SphericalCowww/CubicDoggo_14A/README.md

# CubicDoggo 14A: Homemade 12-DOF 4-Legged Robot Recipe with 6-DOF Arm
Cubic Doggo 14A Googboi is developed from [Cubic Doggo 07B Wouf](https://github.com/SphericalCowww/CubicDoggo_07B), incorporating an [SO-101 arm](https://huggingface.co/docs/lerobot/en/so101). The robot is the simplest Cubic Doggo built for the [Tag of Flag](https://github.com/SphericalCowww/tag_of_flag) game.

## Running SO-101 arms

### Initializing SO-101 with LeRobot services

Note that for this setup, the leader arms are assumed to use virtual servos, such as STS3215-C066 (or WaveShare ST3215 (SE)) that have 7.2 V grading (powered by 5 V supply). 

The servo IDs are 6-1 from top to bottom. Remember to always put on the PLA holder for servo 5 and connect both wires before any other part, as the wires will otherwise be extremely difficult to access afterwards. Then install the arms following [HuggingFace](https://huggingface.co/docs/lerobot/en/so101).

Plug the driver board into the Raspberry Pi:

    dmesg | tail -30
    ls -l /dev/ttyACM*                      # or whatever connection is found
    sudo usermod -aG dialout $USER
    sudo reboot

Install,

    sudo apt install python3.12-venv libevdev-dev ffmpeg

Set up the Python environment to install [LeRobot](https://github.com/huggingface/lerobot),

    cd CubicDoggo_14A/
    cd ..
    python3 -m venv CubicDoggo_14A_env
    source CubicDoggo_14A_env/bin/activate
    pip install --upgrade pip jinja2 pyyaml typeguard setuptools wheel
    git clone https://github.com/huggingface/lerobot.git
    cd lerobot
    pip install -e .
    pip install -e ".[feetech]"

Follow the calibration steps for the follower (see also [YouTube](https://www.youtube.com/watch?v=Nhfda8h7e2I)),

    # plug in the driver board
    lerobot-find-port
    # unplug the driver board
    ## The port of this MotorsBus is '/dev/ttyACM0'
    # plug in the driver board
    ls -l /dev/serial/by-id/
    ## ... usb-1a86_USB_Single_Serial_5C93149822-if00 -> ../../ttyACM0
    lerobot-setup-motors --robot.type=so101_follower --robot.port=/dev/serial/by-id/usb-1a86_USB_Single_Serial_5C93149822-if00
    # Connecting the servos from top to bottom independently to the driver board one-by-one, following the instructions
    ## ... 'shoulder_pan' motor id set to 1
    # After completion, connect all servos in a daisy chain 
    lerobot-calibrate --robot.type=so101_follower --robot.port=/dev/serial/by-id/usb-1a86_USB_Single_Serial_5C93149822-if00 --robot.id=my_follower
    # Follow the instructions

For the leader:

    ls -l /dev/serial/by-id/
    ## ... usb-1a86_USB_Single_Serial_5C93152513-if00 -> ../../ttyACM0
    lerobot-setup-motors --teleop.type=so101_leader --teleop.port=/dev/serial/by-id/usb-1a86_USB_Single_Serial_5C93152513-if00
    # ...
    lerobot-calibrate --teleop.type=so101_leader --teleop.port=/dev/serial/by-id/usb-1a86_USB_Single_Serial_5C93152513-if00 --teleop.id=my_leader

Once everything is done,

    deactivate

### Running SO-101 on ROS

    cd CubicDoggo_14A/
    cd ..
    mkdir so101_ros2
    cd so101_ros2
    git clone https://github.com/adoodevv/so101_ros2.git
    mv so101_ros2 src
    sudo rosdep init
    rosdep update
    rosdep install --from-paths src --ignore-src -r -y
    colcon build --symlink-install
    source install/setup.bash

Connect both driver boards and test out the calibration files, 

    ros2 run so101_hardware so101_hardware_check --port /dev/serial/by-id/usb-1a86_USB_Single_Serial_5C93149822-if00 --calibration ~/.cache/huggingface/lerobot/calibration/robots/so_follower/my_follower.json
    ros2 run so101_hardware so101_hardware_check --port /dev/serial/by-id/usb-1a86_USB_Single_Serial_5C93152513-if00 --calibration ~/.cache/huggingface/lerobot/calibration/teleoperators/so_leader/my_leader.json

Then launch the arms,

    # For no torque with rViz
    ros2 launch so101_bringup so101_real_moveit.launch.py port:=/dev/serial/by-id/usb-1a86_USB_Single_Serial_5C93149822-if00 read_only:=true
    # For powered without rViz
    ros2 launch so101_bringup so101_real_moveit.launch.py port:=/dev/serial/by-id/usb-1a86_USB_Single_Serial_5C93149822-if00 use_rviz:=false 
    # For teleop
    ros2 launch so101_bringup so101_teleop.launch.py port:=/dev/serial/by-id/usb-1a86_USB_Single_Serial_5C93149822-if00 leader_port:=/dev/serial/by-id/usb-1a86_USB_Single_Serial_5C93152513-if00 use_rviz:=false 

## Running servos for the legs

### Initializing servos in ROS with STServo library

Requirement: install ROS2 Jazzy on a Raspberry Pi according to [GitHub](https://github.com/SphericalCowww/ROS_init_practice).

Download ``ST/SC serial bus servo control library (Linux)`` from <a href="https://www.waveshare.com/wiki/Bus_Servo_Adapter_(A)">link</a>, expand it under ``CubicDoggo_14A/src/my_toolbox_scs_workbench/`` and replace ``src/my_toolbox_scs_workbench/SCServo_Linux/SCServo_Linux_220329/SCServo_Linux/CMakeLists.txt``.

    cd CubicDoggo_14A/
    colcon build --packages-select my_toolbox_scs_workbench --cmake-clean-first
    source install/setup.bash

To change the servo ID and initialize the servo, connect only 1 controller and 1 servo,

    vim CubicDoggo_14A/src/my_toolbox_scs_workbench/src/scanUpdateID_zeroing.cpp
    # Modify targetID, EEPROM change is only enabled when ID changes 
    # Modify pos_offset_quick, when settled, set pos_offset_quick=0 and set pos_offset accordingly into the EEPROM
    ros2 run my_toolbox_scs_workbench scanUpdateID_zeroing

Or connect all the servos with IDs listed, update all their EEPROM at once with

    ros2 run my_toolbox_scs_workbench scanUpdateAll_zeroing

**WARNING: DO NOT CTRL-C FOR THESE EEPROM PROCESSES**

Remember to tune and record the pos_offset to set the servo at the correct default position (halfway between minimal and maximal ticks).

To test 1 servo again, do,

    ros2 run my_toolbox_scs_workbench testSpin_servo1

To test 2 servos with 2 controllers, or 3 servos daisy-chained, redo the connection accordingly and do,

    ros2 run my_toolbox_scs_workbench testSpin_servo2controller2
    ros2 run my_toolbox_scs_workbench testSpin_servo3

**NOTE:** Record the ``pos_offset`` for each servo independently such that each of their default position is finely aligned.

**NOTE:** ``sts_wb.writeByte``requires unlocking the EEPROM; do NOT do this firmware change too frequently, otherwise it can cause corruption.

## References:

- Trushant Adeshara, SO101 Arms: Calibration and Motor Configuration
 (<a href="https://www.youtube.com/watch?v=Nhfda8h7e2I">YouTube</a>)
- TheRobotStudio, SO-101 STL files, (<a href="https://github.com/TheRobotStudio/SO-ARM100/tree/main/STL/SO101/Individual">GitHub</a>)

## Acknowledgements

- SO-101 arm hardware kit purchased from [Waveshare](https://www.waveshare.com/wiki/SO-ARM100/101_Kit_Aassembly). Original hardware design by TheRobotStudio ([GitHub](https://github.com/TheRobotStudio/SO-ARM100)) under [Apache-2.0 license](https://github.com/TheRobotStudio/SO-ARM100/blob/main/LICENSE)
- SO-101 arm software package follows LeRobot [GitHub](https://github.com/huggingface/lerobot) under [Apache-2.0 license](https://github.com/huggingface/lerobot/blob/main/LICENSE)
- SO-101 ROS2 Jazzy control forked from adoodevv [GitHub](https://github.com/adoodevv/so101_ros2) under [BSD-3-Clause license](https://github.com/adoodevv/so101_ros2/blob/main/LICENSE)
- Libraries and some examples borrowed from Waveshare: https://www.waveshare.com/wiki/Bus_Servo_Adapter_(A). The license is not specified. For reference only
