SphericalCowww/CubicDoggo_14A/src/my_robot_description/mesh/CADv3_ST-3215-C018/mountArm-Body.stl

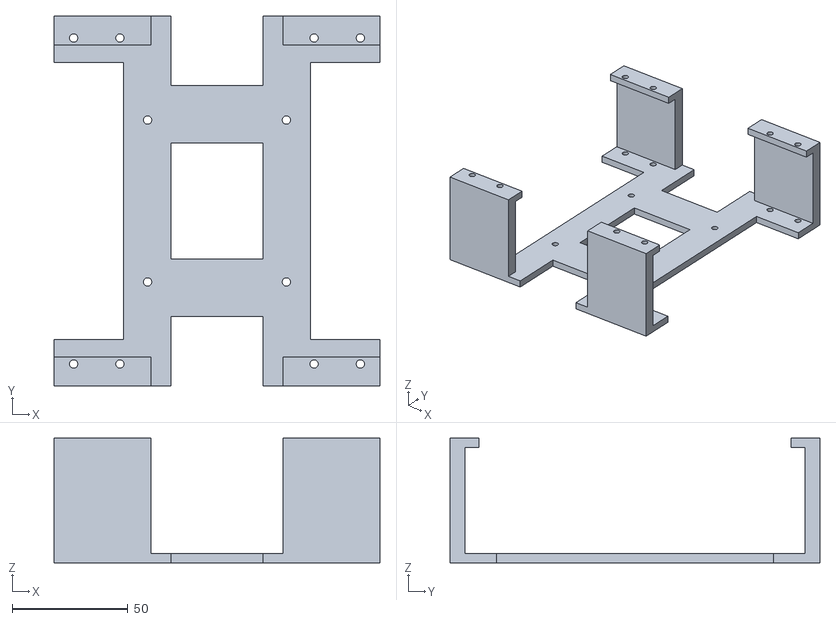
[picture p1: CAD file, 2026-11-07]
src/my_robot_description/mesh/CADv3_ST-3215-C018/mountArm-Body.stl
141.0 x 160.0 x 54.0
