SphericalCowww/CubicDoggo_14A/src/my_robot_description/mesh/CADv3_ST-3215-C018/mountFlag.FCStd

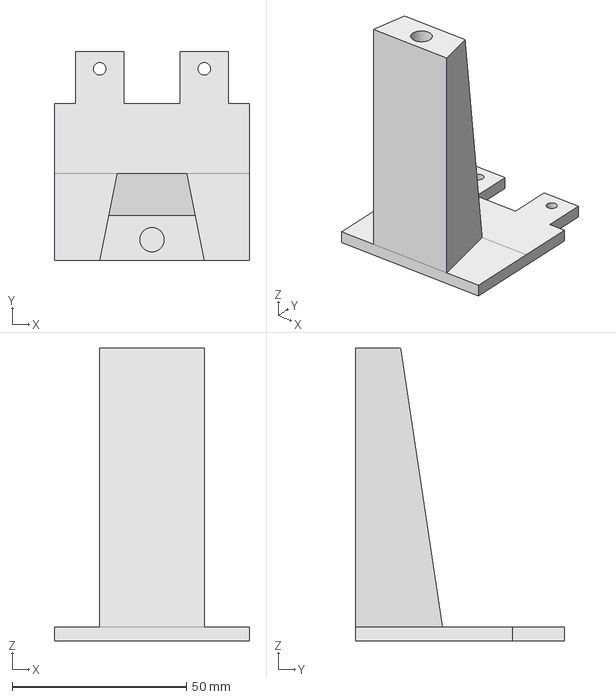
[picture p2: CAD file, 2026-11-07]
src/my_robot_description/mesh/CADv3_ST-3215-C018/mountFlag.FCStd
56.0 x 60.0 x 84.0 mm
