SphericalCowww/CubicDoggo_14A/src/my_robot_description/mesh/CADv3_ST-3215-C018/bodyHolderWide.FCStd

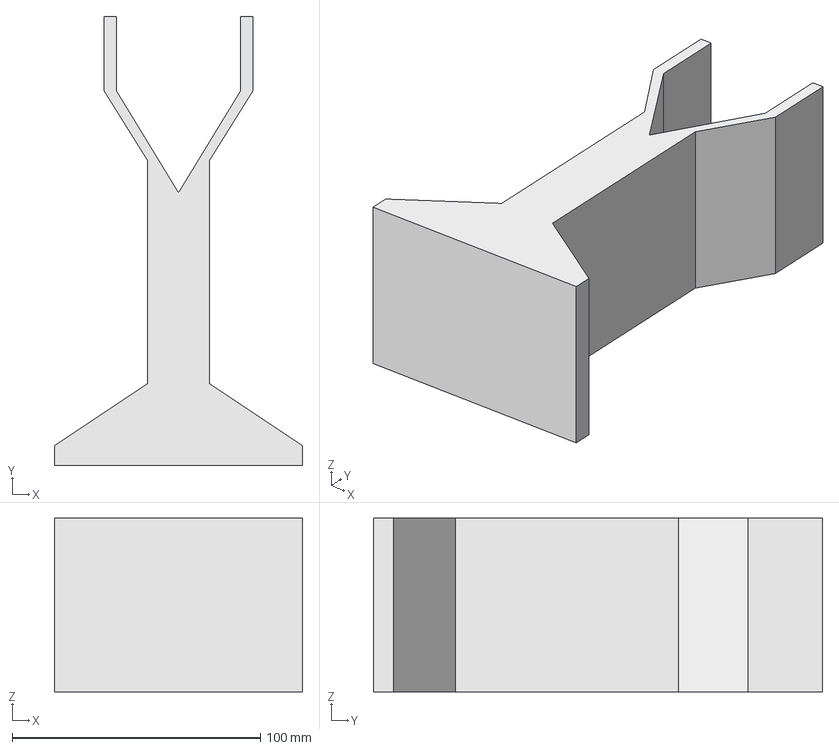
[picture p3: CAD file, 2026-11-06]
src/my_robot_description/mesh/CADv3_ST-3215-C018/bodyHolderWide.FCStd
100.0 x 181.0 x 70.0 mm
