SphericalCowww/CubicDoggo_14A/src/my_robot_description/mesh/CADv3_ST-3215-C018/ST3215thighInner.FCStd

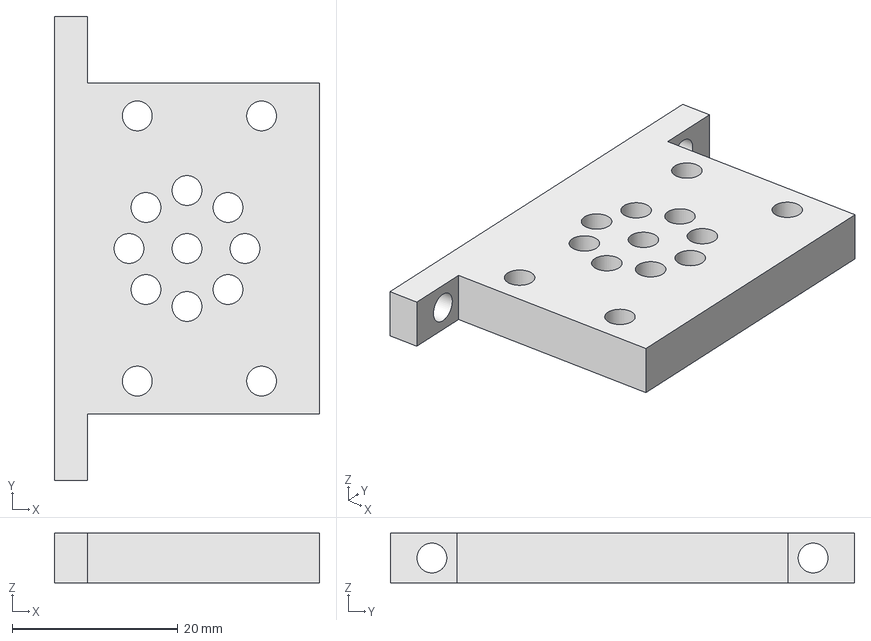
[picture p4: CAD file, 2026-11-06]
src/my_robot_description/mesh/CADv3_ST-3215-C018/ST3215thighInner.FCStd
32.0 x 56.0 x 6.00 mm
