SphericalCowww/CubicDoggo_14A/src/my_robot_description/mesh/CADv3_ST-3215-C018/bodyHolder.FCStd

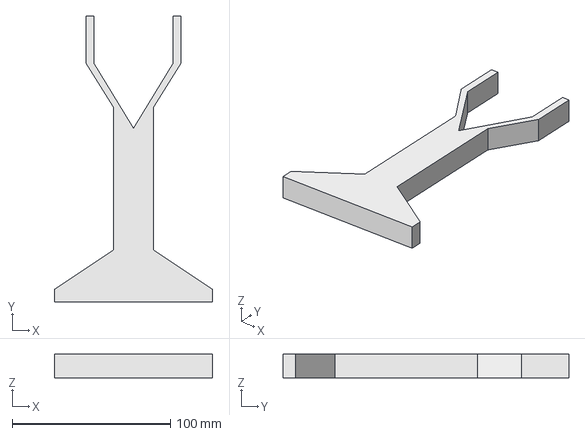
[picture p5: CAD file, 2026-11-06]
src/my_robot_description/mesh/CADv3_ST-3215-C018/bodyHolder.FCStd
100.0 x 181.0 x 15.0 mm
