SphericalCowww/CubicDoggo_14A/src/my_robot_description/mesh/CADv3_ST-3215-C018/baseTorso.FCStd

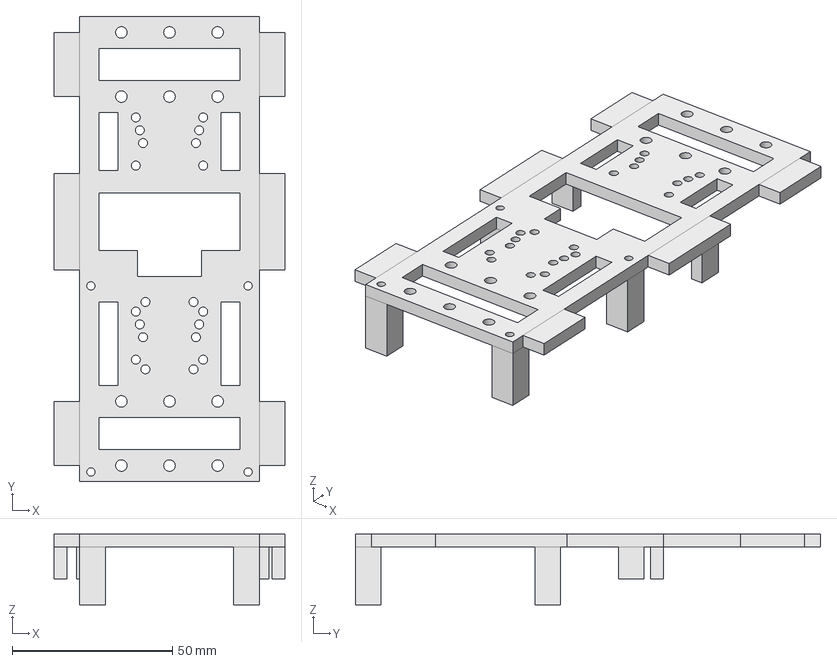
[picture p6: CAD file, 2026-11-06]
src/my_robot_description/mesh/CADv3_ST-3215-C018/baseTorso.FCStd
72.0 x 145.0 x 22.0 mm
