SphericalCowww/CubicDoggo_14A/src/my_robot_description/mesh/CADv3_ST-3215-C018/basePlate.FCStd

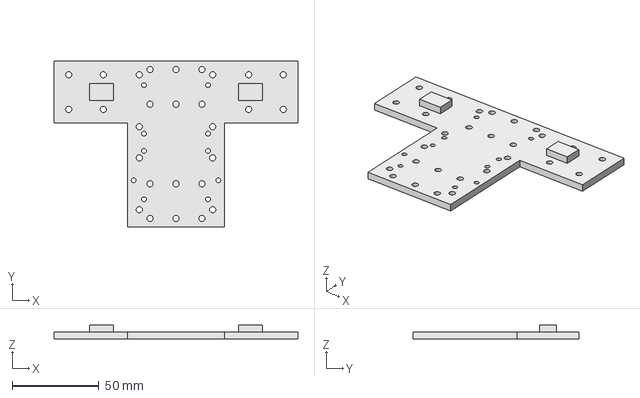
[picture p7: CAD file, 2026-11-06]
src/my_robot_description/mesh/CADv3_ST-3215-C018/basePlate.FCStd
141.0 x 96.0 x 8.00 mm
