SphericalCowww/CubicDoggo_14A/src/my_robot_description/mesh/CADv3_ST-3215-C018/calfFeet.FCStd

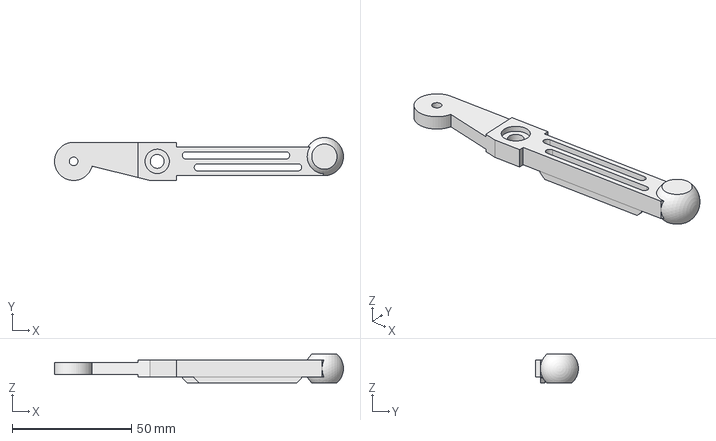
[picture p8: CAD file, 2026-11-06]
src/my_robot_description/mesh/CADv3_ST-3215-C018/calfFeet.FCStd
121.0 x 18.0 x 12.0 mm
