SphericalCowww/CubicDoggo_14A/src/my_robot_description/mesh/CADv3_ST-3215-C018/ST3215rotorPadding.FCStd

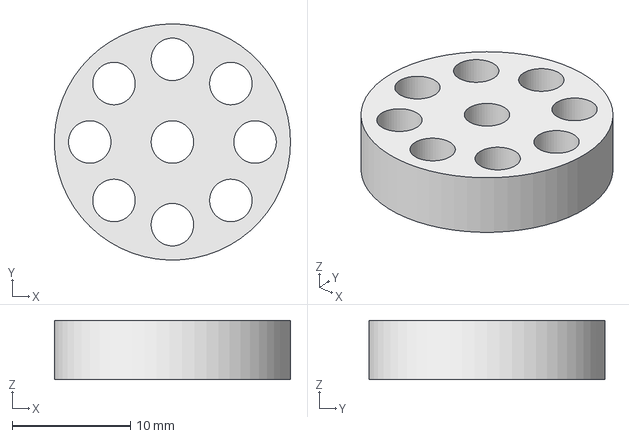
[picture p10: CAD file, 2026-11-06]
src/my_robot_description/mesh/CADv3_ST-3215-C018/ST3215rotorPadding.FCStd
20.0 x 20.0 x 5.00 mm
