SphericalCowww/CubicDoggo_14A/src/my_robot_description/mesh/CADv3_ST-3215-C018/ST3215thighFront.FCStd

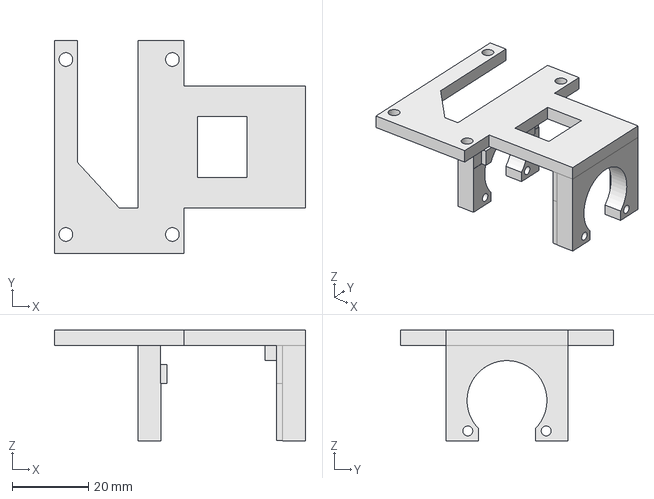
[picture p11: CAD file, 2026-11-06]
src/my_robot_description/mesh/CADv3_ST-3215-C018/ST3215thighFront.FCStd
66.0 x 56.0 x 29.1 mm
