SphericalCowww/CubicDoggo_14A/src/my_robot_description/mesh/CADv3_ST-3215-C018/ST3215thighBack-Body.stl

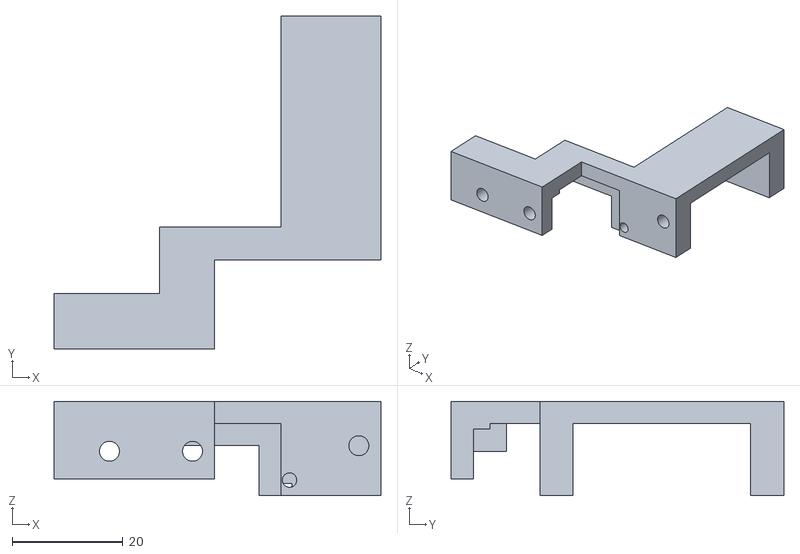
[picture p12: CAD file, 2026-11-06]
src/my_robot_description/mesh/CADv3_ST-3215-C018/ST3215thighBack-Body.stl
59.0 x 60.0 x 17.0
