SphericalCowww/CubicDoggo_14A/src/my_robot_description/mesh/CADv3_ST-3215-C018/ST3215thighOuter.FCStd

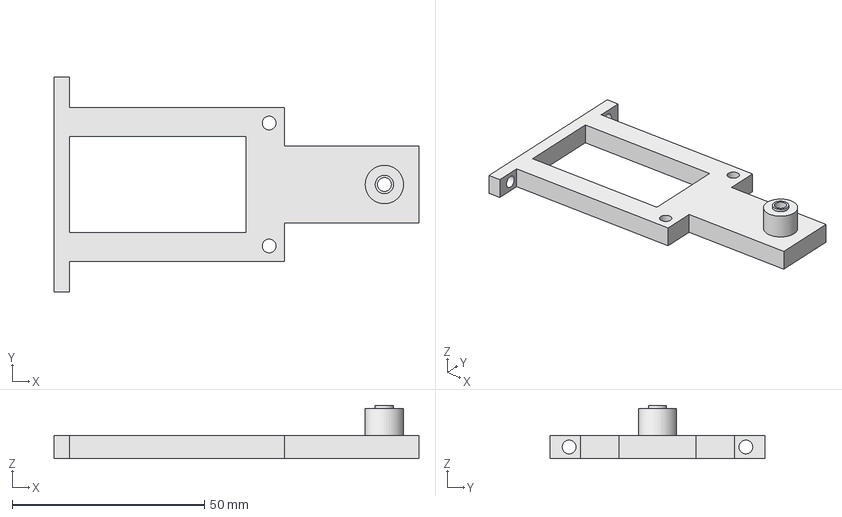
[picture p13: CAD file, 2026-11-06]
src/my_robot_description/mesh/CADv3_ST-3215-C018/ST3215thighOuter.FCStd
95.0 x 56.0 x 13.8 mm
