SphericalCowww/CubicDoggo_14A/src/my_robot_description/mesh/CADv3_ST-3215-C018/lidarHolder-Body.stl

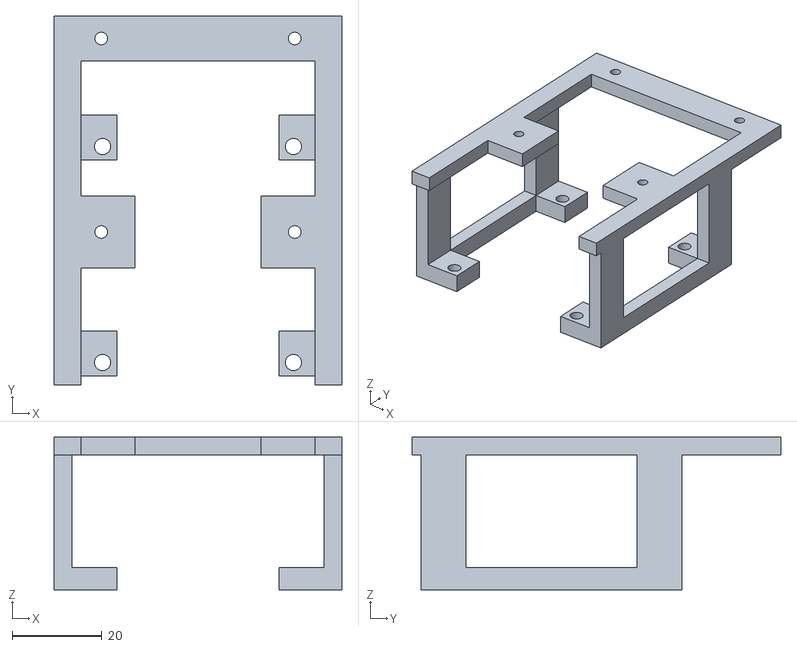
[picture p14: CAD file, 2026-11-06]
src/my_robot_description/mesh/CADv3_ST-3215-C018/lidarHolder-Body.stl
64.0 x 82.0 x 34.0
