SphericalCowww/CubicDoggo_14A/src/my_robot_description/mesh/CADv3_ST-3215-C018/hdmiHolder-Body.stl

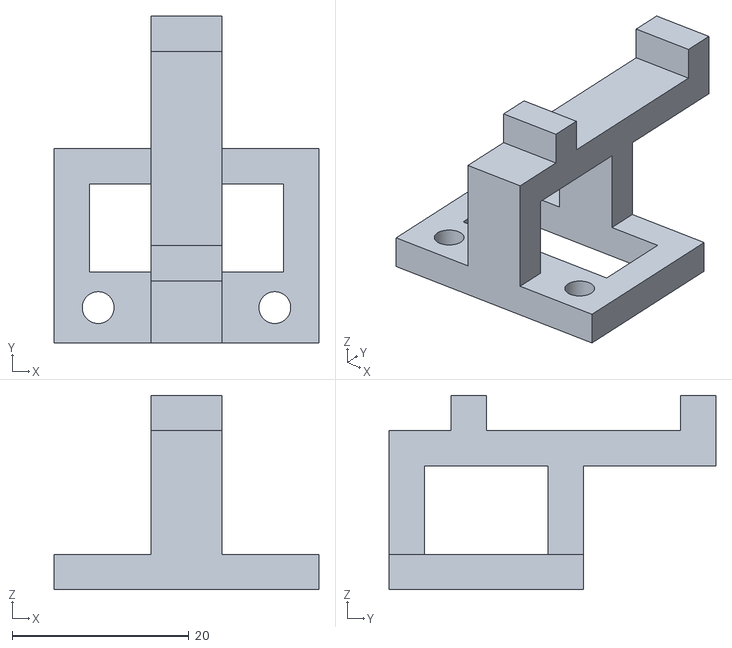
[picture p15: CAD file, 2026-11-06]
src/my_robot_description/mesh/CADv3_ST-3215-C018/hdmiHolder-Body.stl
30.0 x 37.0 x 22.0
