SphericalCowww/CubicDoggo_14A/src/my_robot_description/mesh/CADv3_ST-3215-C018/ST3215holderBottom.FCStd

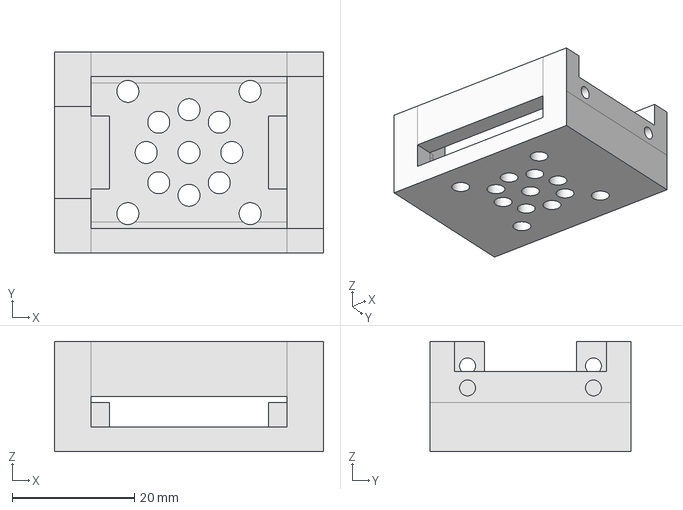
[picture p16: CAD file, 2026-11-06]
src/my_robot_description/mesh/CADv3_ST-3215-C018/ST3215holderBottom.FCStd
44.0 x 32.8 x 18.0 mm
