SphericalCowww/CubicDoggo_14A/src/my_robot_description/mesh/CADv3_ST-3215-C018/bearingPadding-Body.stl

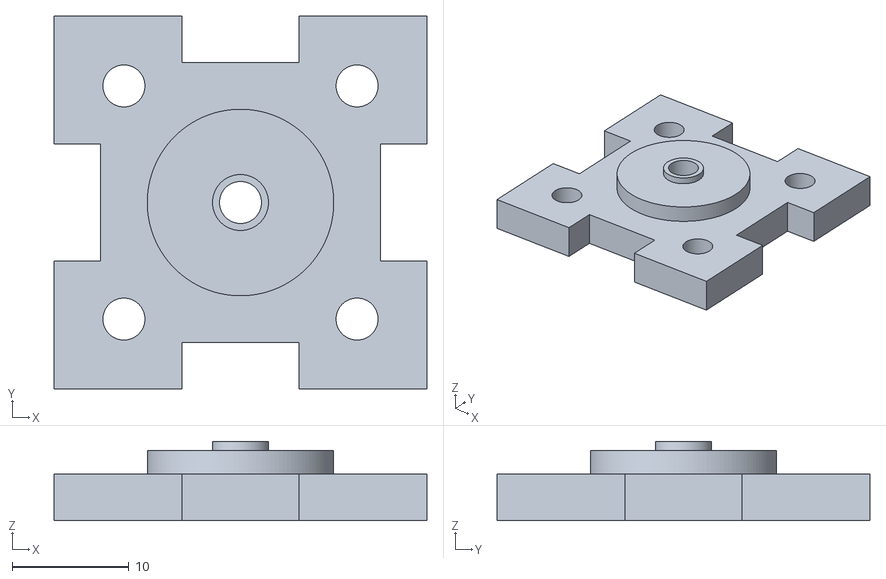
[picture p17: CAD file, 2026-11-06]
src/my_robot_description/mesh/CADv3_ST-3215-C018/bearingPadding-Body.stl
32.0 x 32.0 x 6.80
