SphericalCowww/CubicDoggo_14A/src/my_robot_description/mesh/CADv3_ST-3215-C018/ST3215calfJoint.FCStd

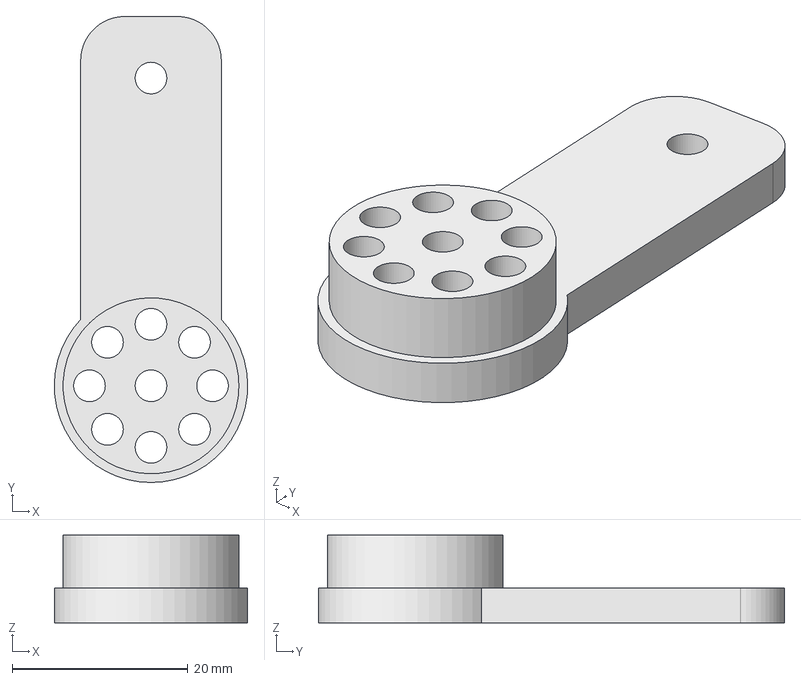
[picture p18: CAD file, 2026-11-06]
src/my_robot_description/mesh/CADv3_ST-3215-C018/ST3215calfJoint.FCStd
22.0 x 53.0 x 10.0 mm
