SphericalCowww/CubicDoggo_14A/src/my_robot_description/mesh/CADv3_ST-3215-C018/ST3215thighFront_GelgoogBlade-Body.stl

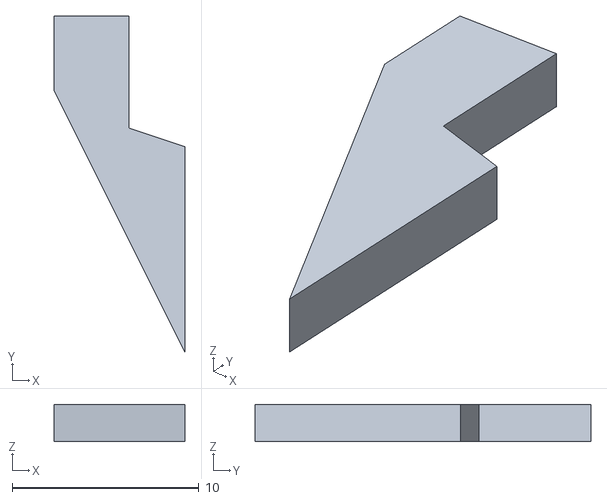
[picture p19: CAD file, 2026-11-06]
src/my_robot_description/mesh/CADv3_ST-3215-C018/ST3215thighFront_GelgoogBlade-Body.stl
7.00 x 18.0 x 2.00
