SphericalCowww/CubicDoggo_14A/src/my_robot_description/mesh/CADv3_ST-3215-C018/batteryHolder.FCStd

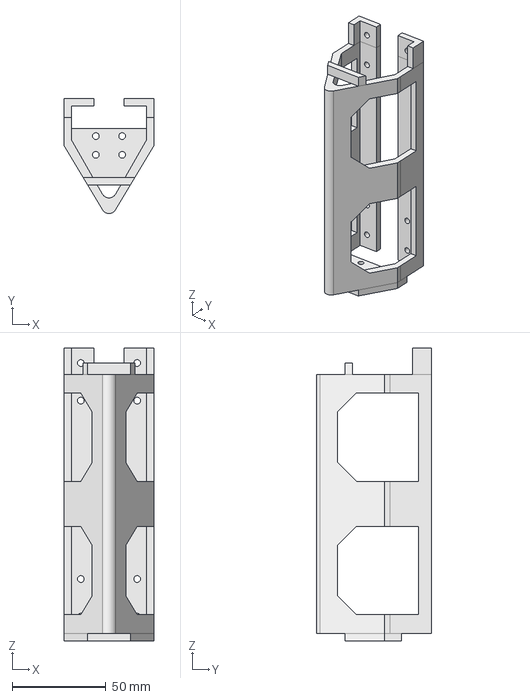
[picture p20: CAD file, 2026-11-06]
src/my_robot_description/mesh/CADv3_ST-3215-C018/batteryHolder.FCStd
48.0 x 61.2 x 156.0 mm
