SphericalCowww/CubicDoggo_14A/src/my_robot_description/mesh/CADv3_ST-3215-C018/bearingPlate.FCStd

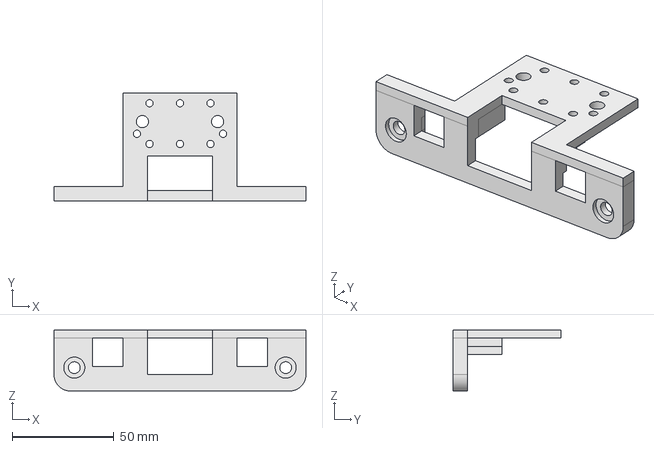
[picture p22: CAD file, 2026-11-06]
src/my_robot_description/mesh/CADv3_ST-3215-C018/bearingPlate.FCStd
124.0 x 53.0 x 30.0 mm
