SphericalCowww/CubicDoggo_14A/(list of files, cad)

Other CAD files:
src/my_robot_description/mesh/CADv3_ST-3215-C018/mountArm.FCStd
src/my_robot_description/mesh/CADv3_ST-3215-C018/mountFlag-Body.stl
src/my_robot_description/mesh/CADv3_ST-3215-C018/basePlate-Body.stl
src/my_robot_description/mesh/CADv3_ST-3215-C018/ST3215thighFront-Body.stl
src/my_robot_description/mesh/CADv3_ST-3215-C018/ST3215thighFront_GelgoogBlade.FCStd
src/my_robot_description/mesh/CADv3_ST-3215-C018/lidarHolder.FCStd
src/my_robot_description/mesh/CADv3_ST-3215-C018/bearingPadding.FCStd
src/my_robot_description/mesh/CADv3_ST-3215-C018/batteryHolder-Body.stl
src/my_robot_description/mesh/CADv3_ST-3215-C018/ST3215rotorPadding-Body.stl
src/my_robot_description/mesh/CADv3_ST-3215-C018/ST3215thighFront_Gelgoog-Body.stl
src/my_robot_description/mesh/CADv3_ST-3215-C018/bearingPlate-Body.stl
src/my_robot_description/mesh/CADv3_ST-3215-C018/hdmiHolder.FCStd
src/my_robot_description/mesh/CADv3_ST-3215-C018/ST3215thighBack.FCStd
src/my_robot_description/mesh/CADv3_ST-3215-C018/ST3215calfJoint.stl
src/my_robot_description/mesh/CADv3_ST-3215-C018/ST3215holderBottom.stl
src/my_robot_description/mesh/CADv3_ST-3215-C018/ST3215holderTop.stl
src/my_robot_description/mesh/CADv3_ST-3215-C018/ST3215thighInner.stl
src/my_robot_description/mesh/CADv3_ST-3215-C018/ST3215thighOuter.stl
src/my_robot_description/mesh/CADv3_ST-3215-C018/basePlate.stl
src/my_robot_description/mesh/CADv3_ST-3215-C018/baseTorso.stl
src/my_robot_description/mesh/CADv3_ST-3215-C018/calfFeet.stl
