SphericalCowww/CubicDoggo_14A/(commit log)

2026-11-06 - initial commits
    [ST3215calfJoint.FCStd, ST3215calfJoint.stl, ST3215holderBottom.FCStd, ST3215holderBottom.stl, ST3215holderTop.FCStd, ST3215holderTop.stl, ST3215rotorPadding-Body.stl, ST3215rotorPadding.FCStd]
2026-11-06 - adding flagMount geometry
    [ST3215thighFront_Gelgoog-Body.stl, ST3215thighFront_Gelgoog.FCStd, ST3215thighFront_GelgoogBlade-Body.stl, ST3215thighFront_GelgoogBlade.FCStd, fanFlag.FCStd, flagMount-Body.stl, flagMount.FCStd]
2026-11-07 - adding arm mount - adjust flag mount, should be final
    [flagMount-Body.stl, flagMount.FCStd, mountArm-Body.stl, mountArm.FCStd, mountFlag-Body.stl, mountFlag.FCStd]
